johnMamish/Metronomev1/pcb/BOM.xlsx

Part Function |  | Value | Maufacturer | Manufacturer Part Number | Supplier | Supplier Part Number | Qty | Notes | TODOs
Major componenets
Main MCU | U1 |  | Atmel |  | Digikey |  | 1
System interconnect CPLD |  |  | Lattice Semiconductor | LCMXO2-640HC-4TG100C | Digikey | 220-1492-ND | 1
Audio DAC |  |  | Texas Instruments | PCM1774 | Digikey | 296-22036-1-ND | 1
UART <--> USB bridge |  |  | Silabs | CP2102-GMR | Digikey | 336-1160-1-ND | 1
3.3V LDO |  |  | ON Semiconductor |  | Digikey | MC33269D-3.3GOS-ND | 1
5V LDO |  |  | ON Semiconductor |  | Digikey | MC33269D-5.0GOS-ND | 1
Passives
3.3V regulator output smoothing cap | C16 |  | Kemet | T491A106K016AT | Digikey | 399-8269-1-ND | 1
5.0V regulator output smoothing cap | C15 |  | Kemet | T491A106K016AT | Digikey | 399-8269-1-ND | 1
Wall wart input smoothing cap | C1 |  | TDK Corporation | C1005JB1V334K050BC | Digikey | 445-11020-1-ND | 1
Main crystal oscillator | Y1 | 12MHz | TXC | 9C-12.000MEEJ-T | Digikey | 887-1268-1-ND | 1 |  | source SMALLER SMD!
Main crystal external capacitors | C2, C3 | 10pF | Kemet | CBR04C100F5GAC | Digikey | 399-8805-1-ND | 2 | According to the SAM4S datasheet, page 1146, Cext = 2*(Ccrystal - CL - Cpcb). From the datasheet, CL = 9.5pF. I can estimate the Cpcb = 3.5pF, so Cext = 2*(18 - 9.5 - 3.5) = 2*5 = 10pF
RTC Crystal
vddin smoothing cap 1 | C5 | 100nF | Kemet | C0402C104K4RACTU | Digikey | 399-3521-1-ND | 1
vddin smoothing cap 2 | C4 | 4.7uF | Kemet | C0603C475K8PACTU | Digikey | 399-5503-1-ND | 1
vddout smoothing cap 1 | C6 | 100nF | Kemet | C0402C104K4RACTU | Digikey | 399-3521-1-ND | 1
vddout smoothing cap 2 | C7 | 2.2uF | Kemet | C0603C225K8PACTU | Digikey | 399-4911-1-ND | 1
vddcore smoothing caps | C8, C11, C12 | 100nF | Kemet | C0402C104K4RACTU | Digikey | 399-3521-1-ND | 3
vddio smoothing caps | C9, C10, C13 | 100nF | Kemet | C0402C104K4RACTU | Digikey | 399-3521-1-ND | 3
CP2102 regulator smoothing caps | C17, C18 | 2.2uF, 100nF | Kemet | C0603C225K8PACTU, C0402C104K4RACTU | Digikey | 399-4911-1-ND, 399-3521-1-ND | 1, 1
CP2102 connection indication LED | D1 | Green | ??? | ??? | Sparkfun | COM-11169 | 1
CP2102 indication LED resistor | R3 | 100Ohm | Panasonic | ERJ-2GEJ101X | Digikey | P100JCT-ND | 1
CP2102 NC pullup resistor | R1 | 1kOhm | Panasonic | ERJ-2GEJ102X | Digikey | P1.0KJCT-ND | 1
CP2102 reset pullup resistor | R2 | 1kOhm | Panasonic | ERJ-2GEJ102X | Digikey | P1.0KJCT-ND | 1
Connectors
SWD Connector | J1 |  | FCI | 20021521-00010T1LF | Digikey | 609-4054-ND | 1
Power Barrel Plug | J2 |  | CUI Inc | PJ-202A | Sparkfun | PRT-00119 | 1
USB Mini B port | J3 |  | Hirose | UX60SC-MB-5ST(80) | Digikey | H11671CT-ND | 1
Development Tools
IDC (SWD) Cable |  |  | ??? | ??? | Adafruit | 1675
JTAG to SWD adapter board |  |  | Adafruit | 2094 | Adafruit | 2094
SAM-ICE |  |  | Segger | ??? | Digikey/"borrowing" from Ed | AT91SAM-ICE-ND
Bus blaster V3 for lattice machxo2 |  |  | Seeed Studio | TES04082P | Seeed Studio | TES04082P
