johnMamish/Metronomev1/pcb/metronome.brd

## EAGLE design pcb/metronome.brd (2014-12-04)

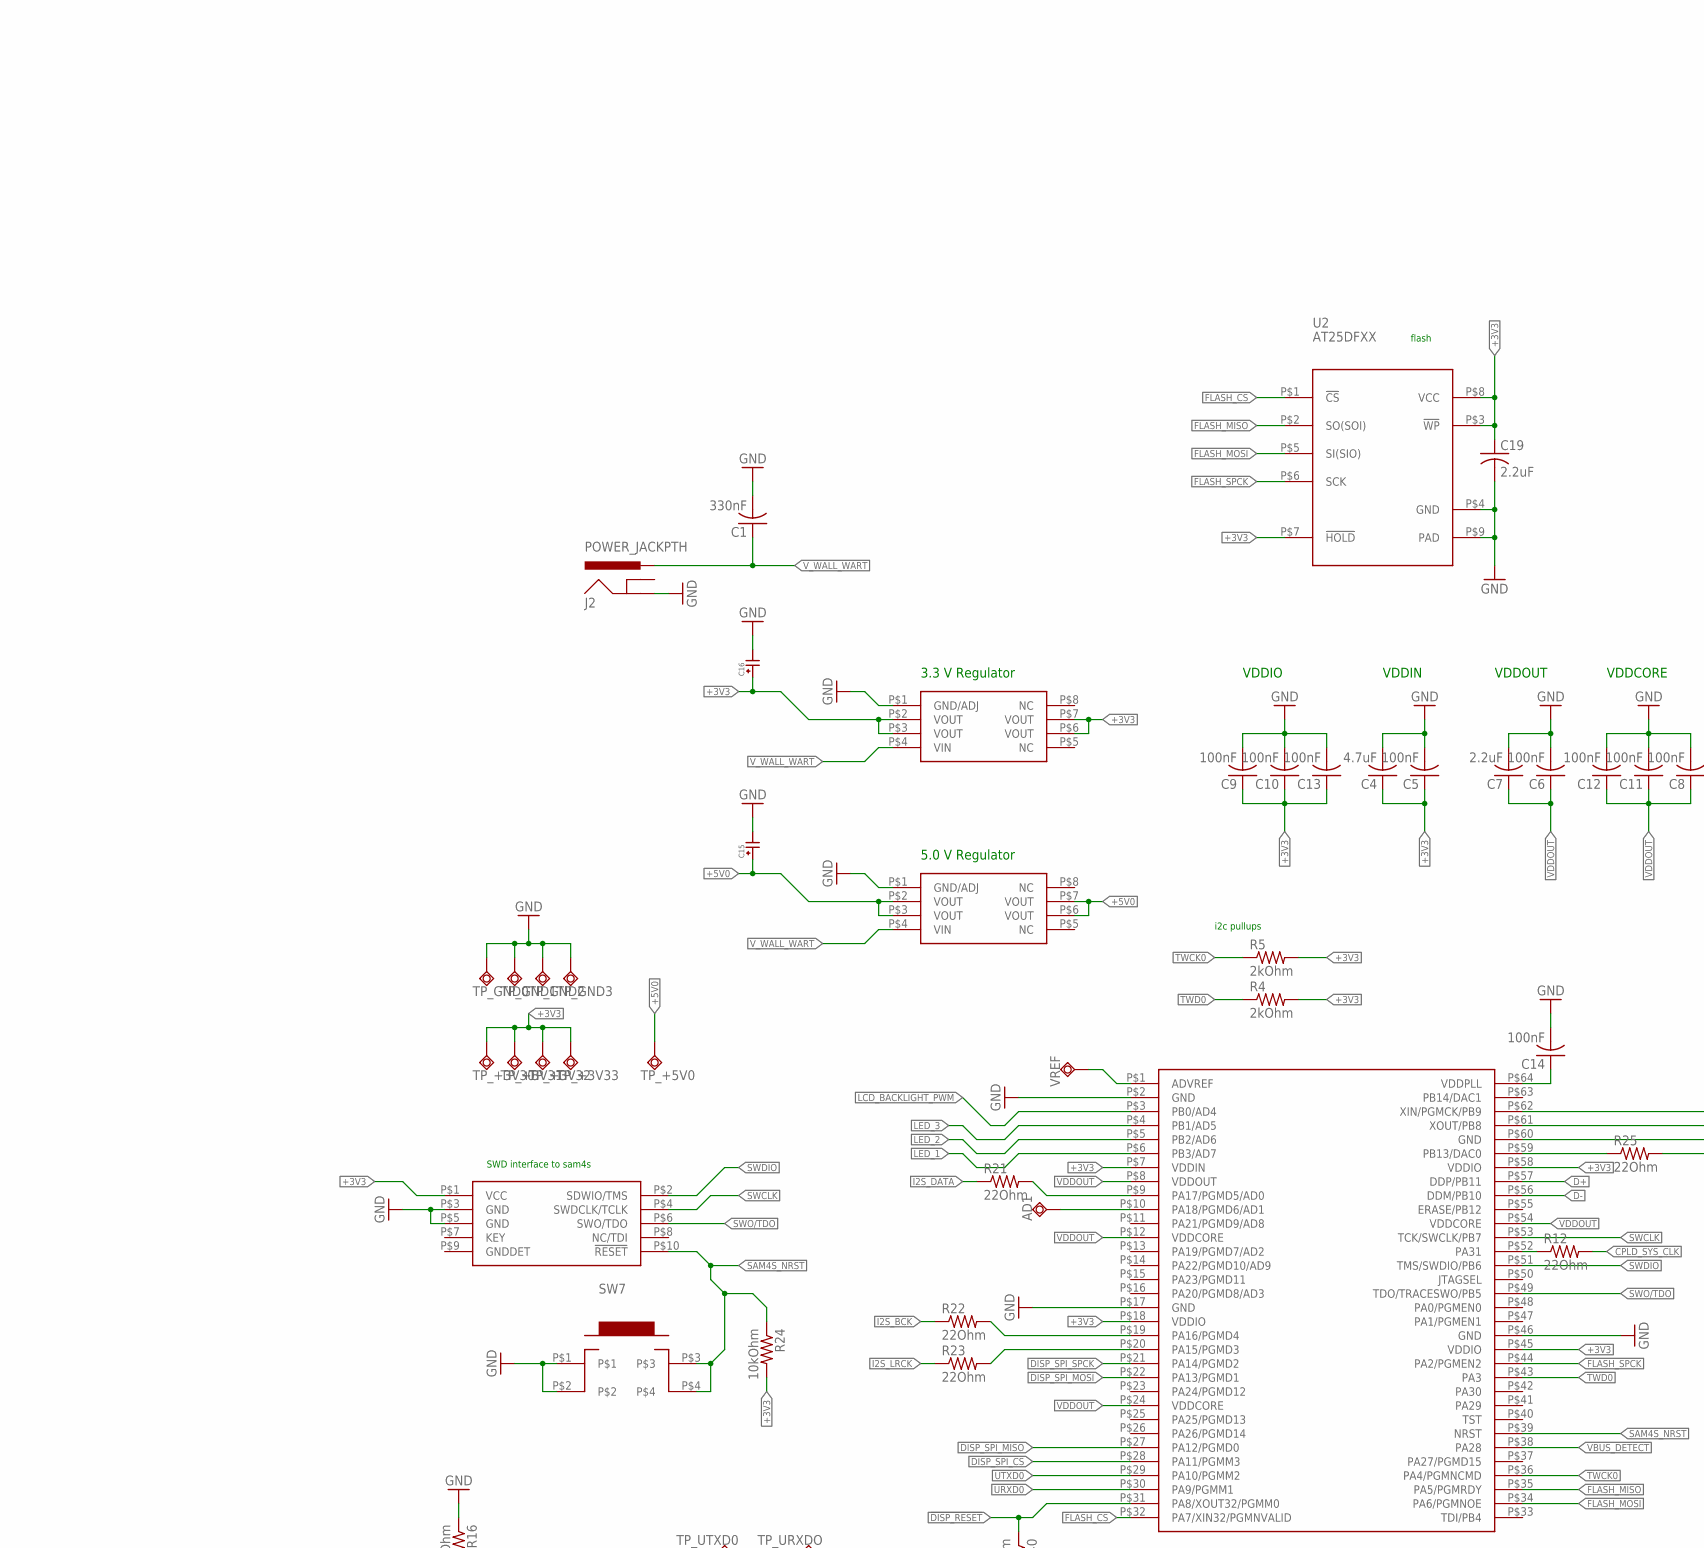
[picture p1: schematic metronome.sch, part in row 1, column 1]

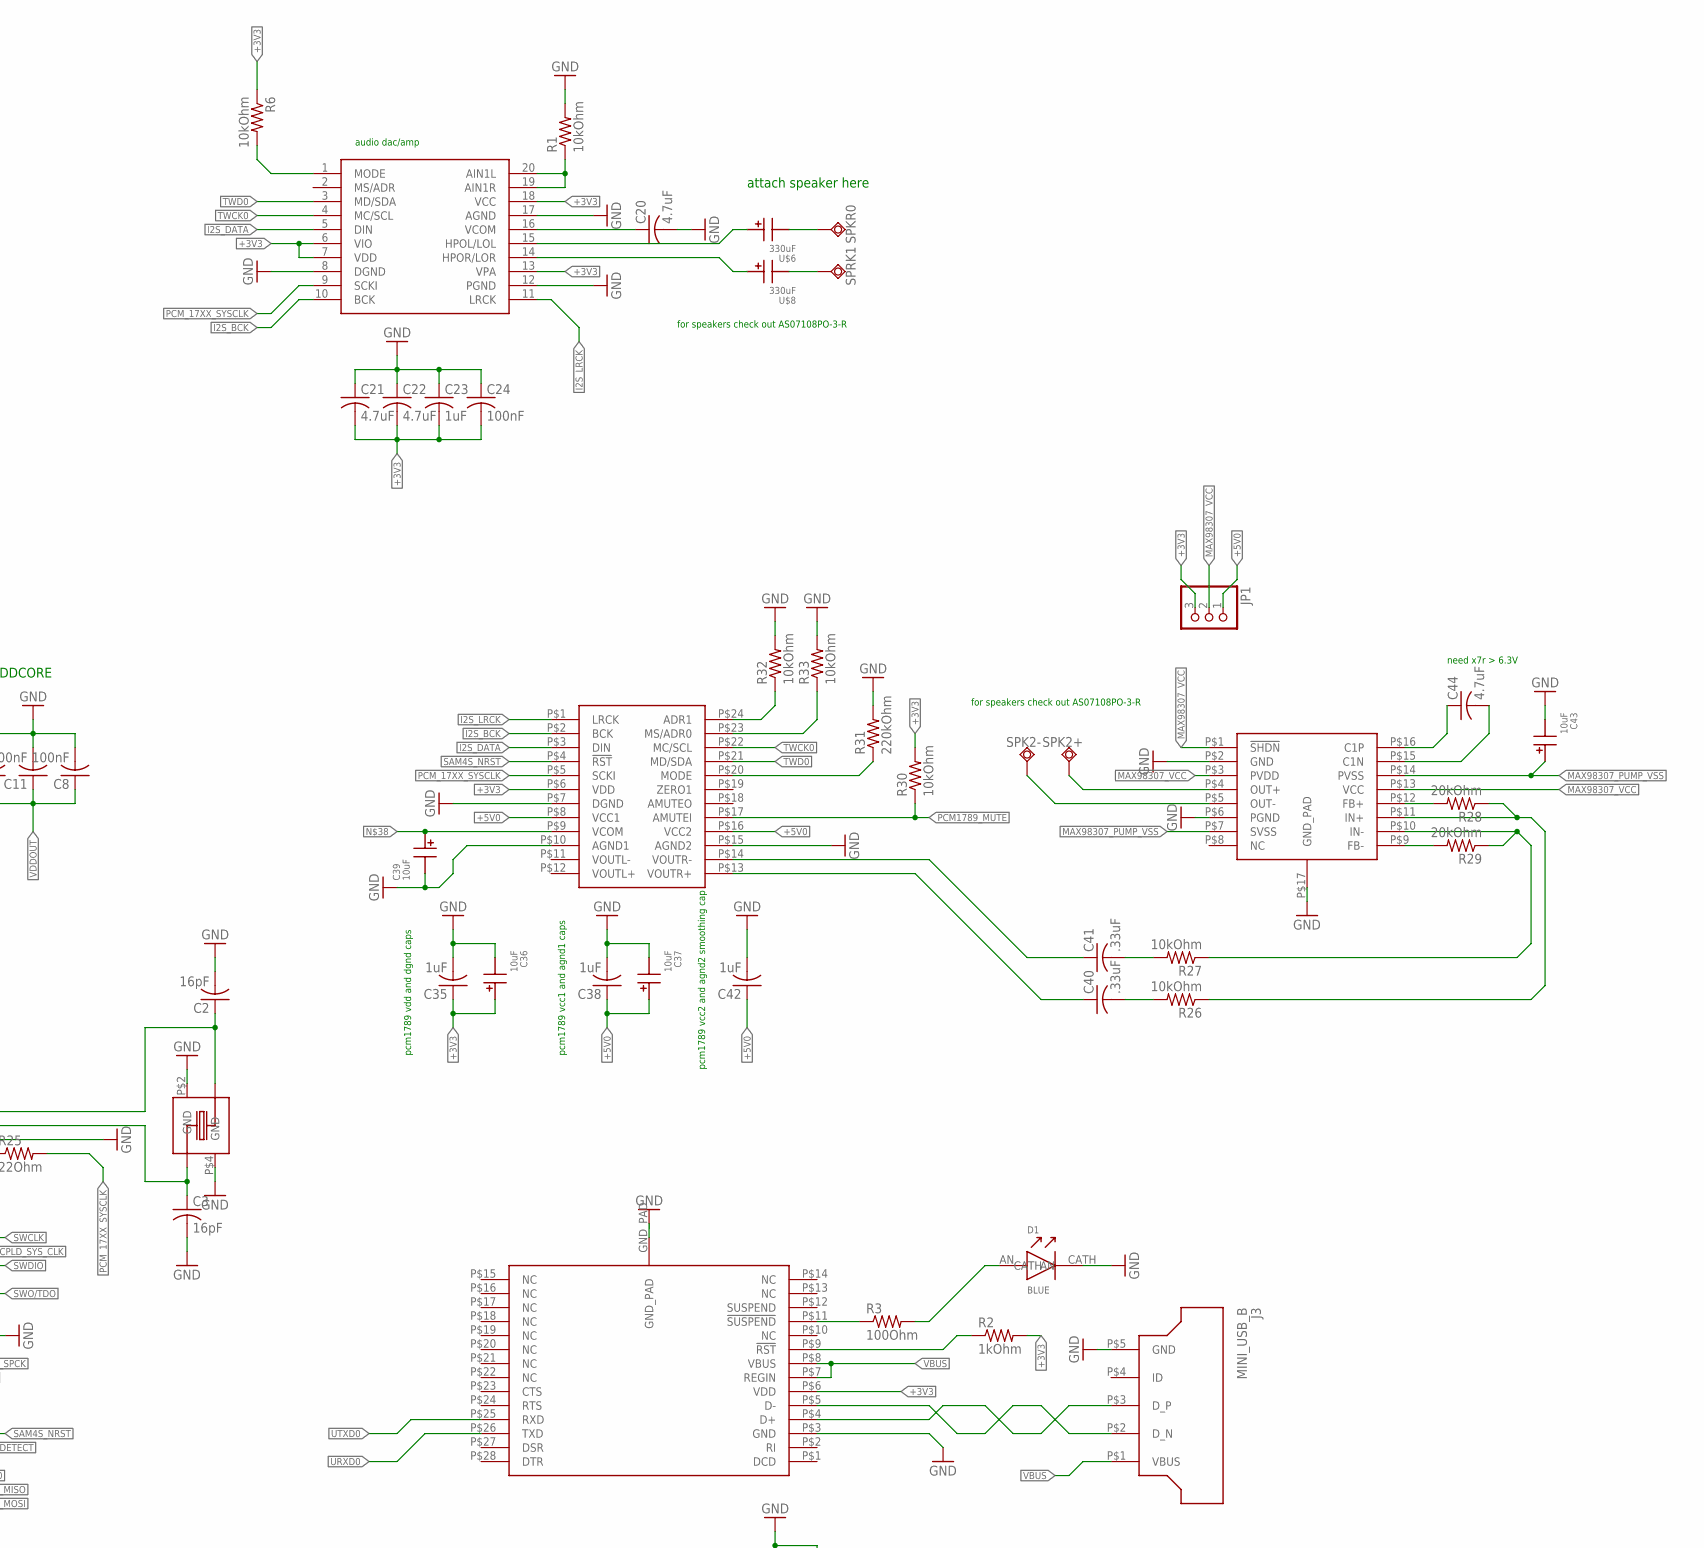
[picture p2: schematic metronome.sch, part in row 1, column 2]

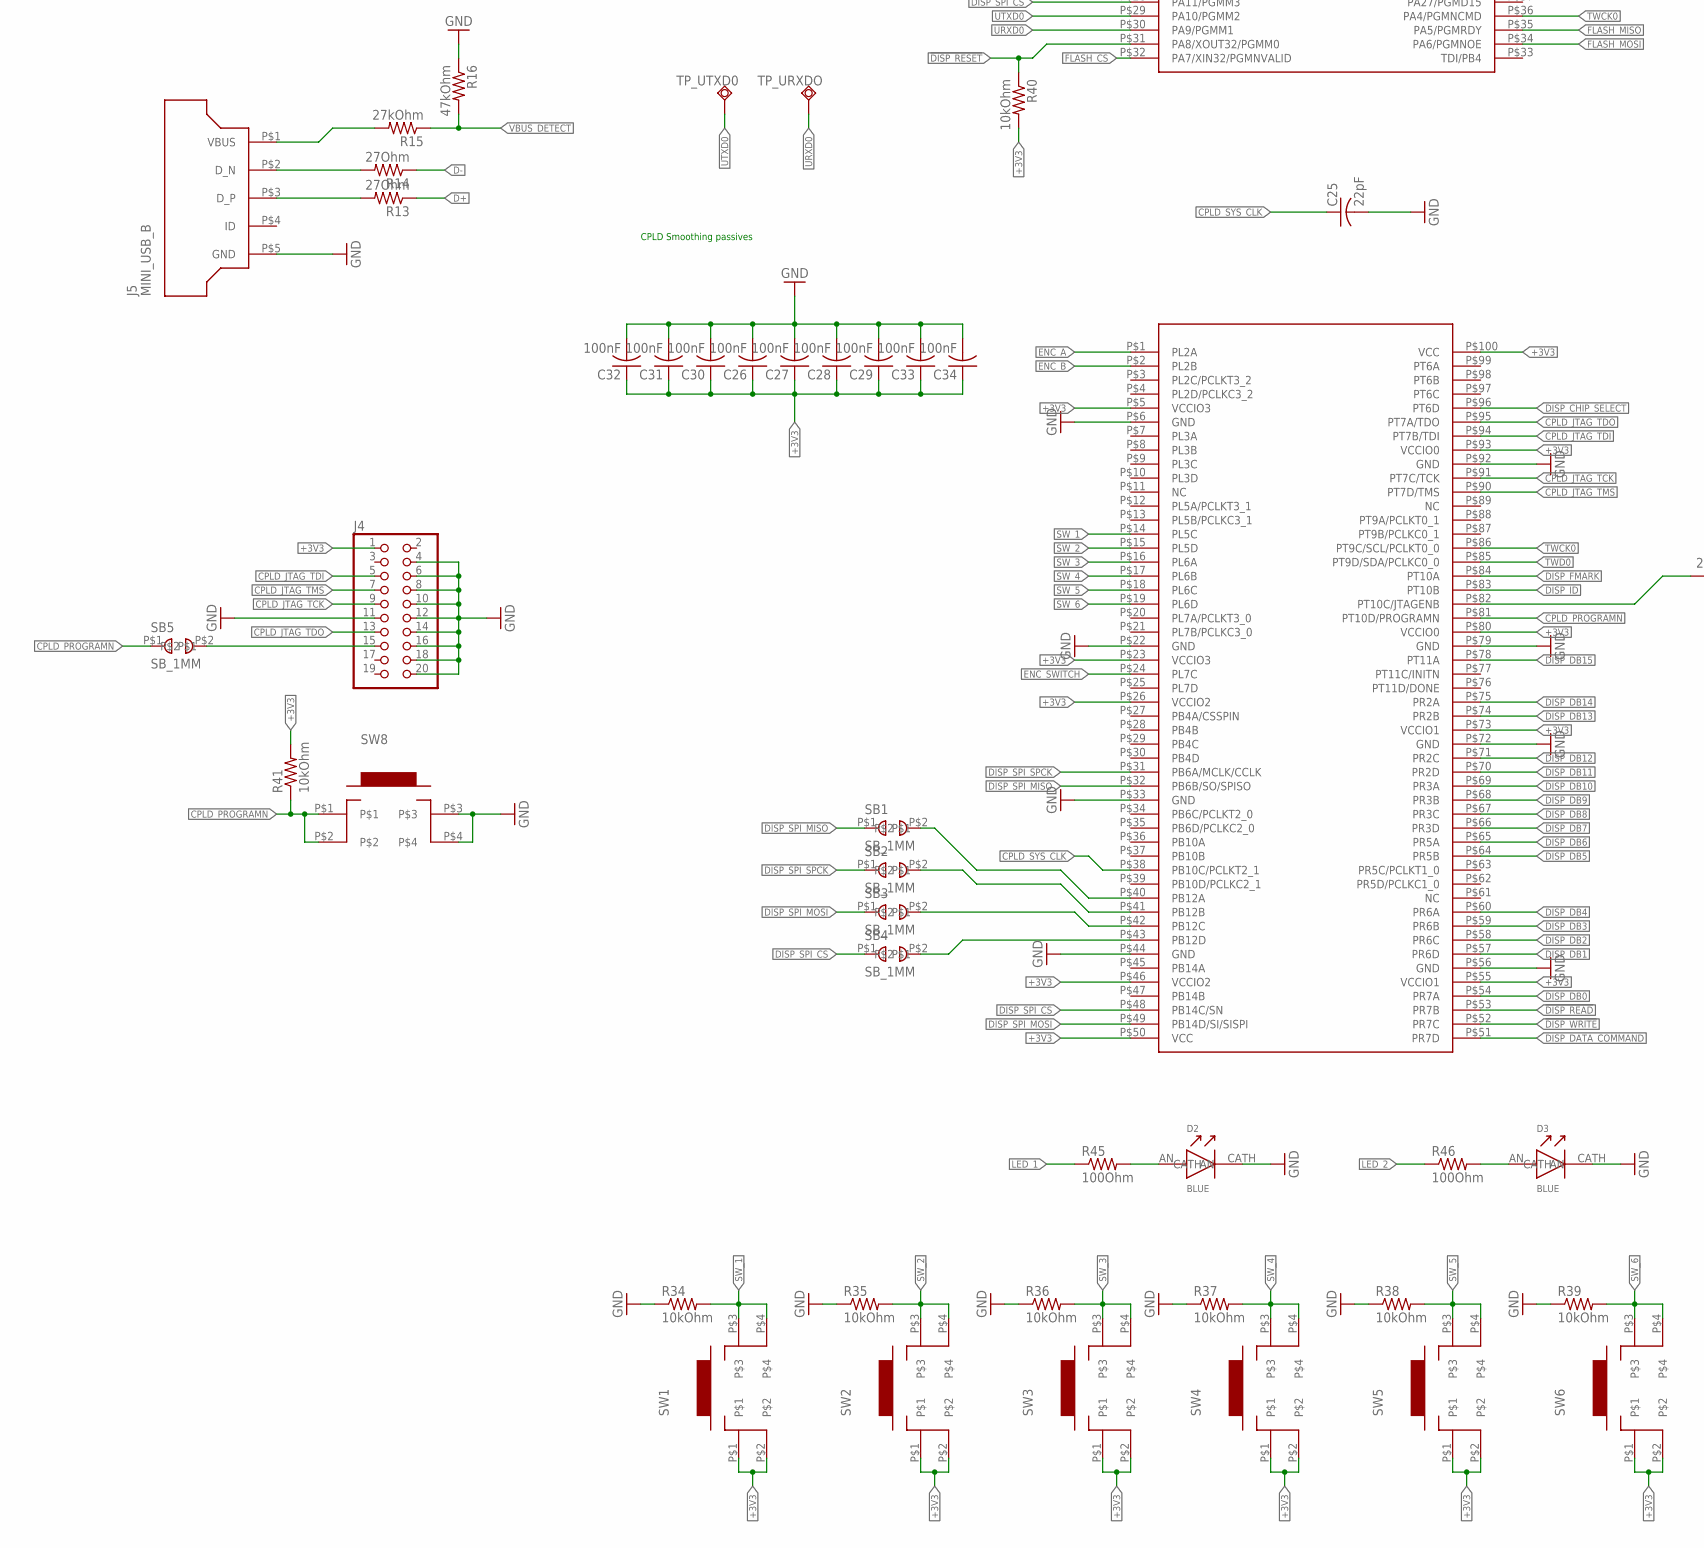
[picture p3: schematic metronome.sch, part in row 2, column 1]

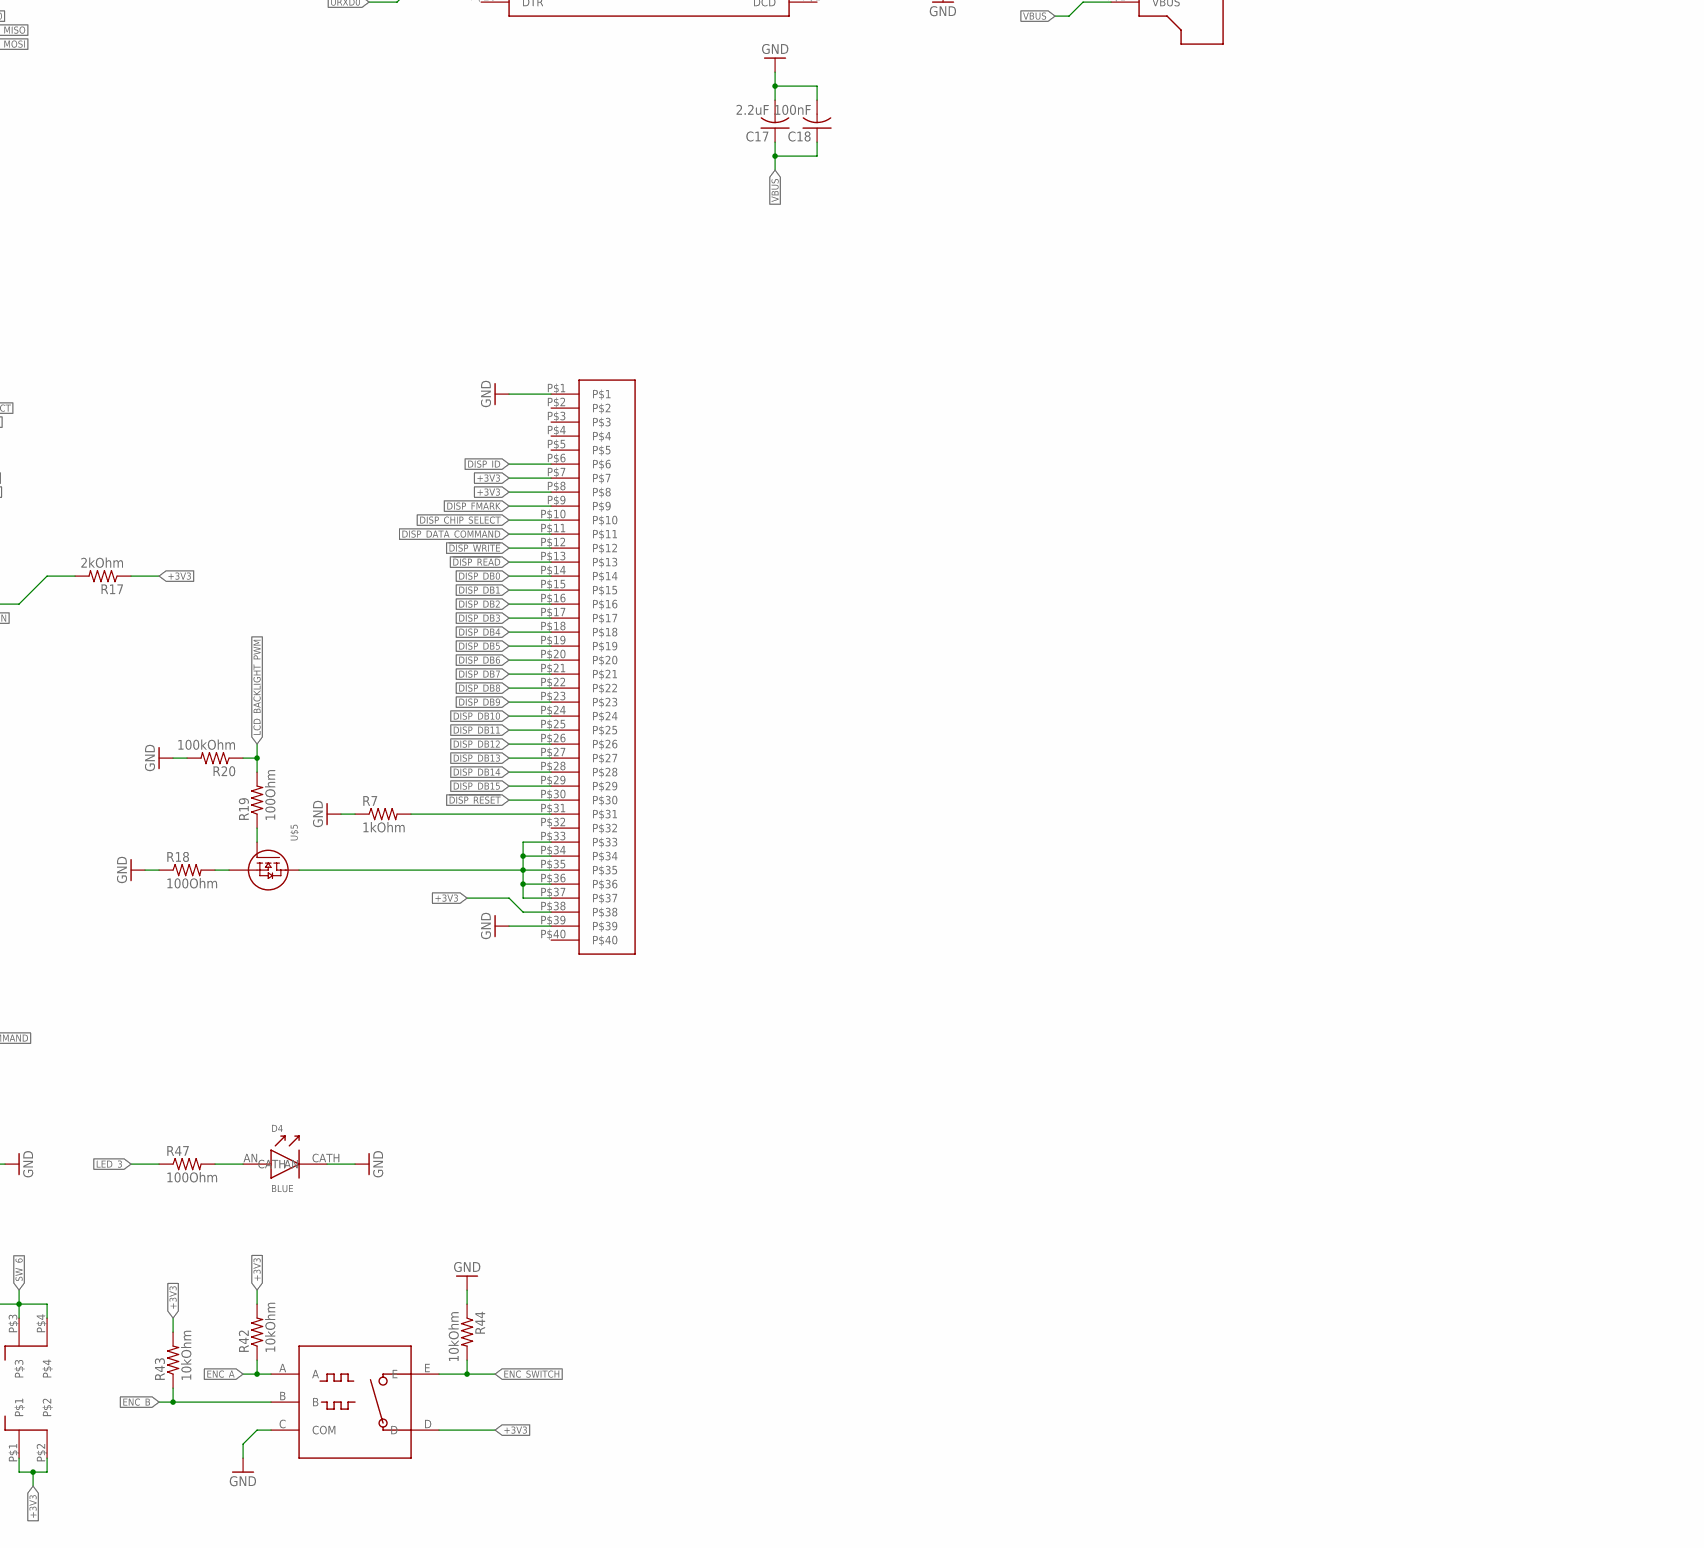
[picture p4: schematic metronome.sch, part in row 2, column 2]

Parts:
3.3_V_REG: MC33269D-3.3GOS-ND; ON_SEMICONDUCTOR_MC33269
5.0_V_REG: MC33269D-5.0GOS-ND; ON_SEMICONDUCTOR_MC33269
AD1: TPSQTP13SQ; TP13SQ
C1: 330nF; C0402
C2, C3: 16pF; C0402
C4, C44: 4.7uF; C0603
C5, C6, C8, C9, C10, C11, C12, C13, C14, C18, C24, C26, C27, C28, C29, C30, C31, C32, C33, C34: 100nF; C0402
C7, C17, C19: 2.2uF; C0603
C15, C16: KEMET_T491A
C20, C21, C22: 4.7uF; C0402
C23, C35, C38, C42: 1uF; C0402
C25: 22pF; C0402
C36, C37, C39, C43: 10uF; PANASONIC_EEEHB100AR
C40, C41: .33uF; C0402
D1, D2, D3, D4: BLUE; D0603
J1: FCI_CORTEX_SWD_CONNECTOR; FCI_10_PIN_SMD_0.5
J2: POWER_JACKPTH; POWER_JACK_PTH
J3, J5: MINI_USB_B; UX60SC-MB-5ST
J4: PINHD-2X10; 2X10
JP1: PINHD-1X3; 1X03
R1, R6, R24, R26, R27, R30, R32, R33, R34, R35, R36, R37, R38, R39, R40, R41, R42, R43, R44: 10kOhm; R0402
R2, R7: 1kOhm; R0402
R3, R18, R19, R45, R46, R47: 100Ohm; R0402
R4, R5, R17: 2kOhm; R0402
R12, R21, R22, R23, R25: 22Ohm; R0402
R13, R14: 27Ohm; R0402
R15: 27kOhm; R0402
R16: 47kOhm; R0402
R20: 100kOhm; R0402
R28, R29: 20kOhm; R0402
R31: 220kOhm; R0402
SB1, SB2, SB3, SB4, SB5: SB_1MM
SPK2+, SPK2-: TPSQTP20SQ; TP20SQ
SPKR0: TPSQTP20SQ; TP20SQ
SPRK1: TPSQTP20SQ; TP20SQ
SW1, SW2, SW3, SW4, SW5, SW6, SW7, SW8: FSMJSMA
TP_+3V30, TP_+3V31, TP_+3V32, TP_+3V33, TP_+5V0: TPSQTP20SQ; TP20SQ
TP_GND0, TP_GND1, TP_GND2, TP_GND3: TPSQTP20SQ; TP20SQ
TP_URXDO: TPSQTP20SQ; TP20SQ
TP_UTXD0: TPSQTP20SQ; TP20SQ
U1: ATSAMD4S2BA-AU; ATMEL_10X10_QFP_64
U2: AT25DFXX1X-M; 8MA1-UDFN
U$1: LATTICE_LCMXO2-640HC-4TG100C; LATTICE_MACHXO_TQFP100
U$2: TI_PCM1774; TI_QFN_20
U$3: ECS_ECS-120-20-33-CKM-TR; ECS_ECX-32
U$4: 40_PIN_MOLEX_FFC
U$5: DIODES_INCORPORATED_2N7002-7-F; DIODES_INCORPORATED_SOT23
U$6, U$8: 330uF; PANASONIC_EEEFT0JXXX
U$7: SILABS_CP2102; SILABS_QFN28
U$9: TI_PCM1789; TI_PW_TSSOP_24
U$10: MAXIM_MAX_98307; MAXIM_16_TQFN_T1633-5
U$11: BOURNS_PEC16-4215F-S0024; BOURNS_PEC16-4XXXF-SXXXX
VREF: TPSQTP13SQ; TP13SQ

Connections:
!DISP_READ!: U$1.P$53 (PR7B), U$4.P$13
!DISP_RESET!: R40.1, U1.P$31 (PA8/XOUT32/PGMM0), U$4.P$30
!DISP_WRITE!: U$1.P$52 (PR7C), U$4.P$12
+3V3: 3.3_V_REG.P$2 (VOUT), 3.3_V_REG.P$3 (VOUT), 3.3_V_REG.P$6 (VOUT), 3.3_V_REG.P$7 (VOUT), C4.1, C5.1, C9.1, C10.1, C13.1, C16.POS, C19.1, C21.2, C22.2, C23.2, C24.2, C26.1, C27.1, C28.1, C29.1, C30.1, C31.1, C32.1, C33.1, C34.1, C35.1, C36.POS, J1.P$1 (VCC), J4.1, JP1.3, R2.2, R4.2, R5.2, R6.1, R17.1, R24.2, R30.2, R40.2, R41.2, R42.2, R43.2, SW1.P$1, SW1.P$2, SW2.P$1, SW2.P$2, SW3.P$1, SW3.P$2, SW4.P$1, SW4.P$2, SW5.P$1, SW5.P$2, SW6.P$1, SW6.P$2, TP_+3V30.TP, TP_+3V31.TP, TP_+3V32.TP, TP_+3V33.TP, U1.P$7 (VDDIN), U1.P$18 (VDDIO), U1.P$45 (VDDIO), U1.P$58 (VDDIO), U2.P$3 (!WP!), U2.P$7 (!HOLD!), U2.P$8 (VCC), U$1.P$5 (VCCIO3), U$1.P$23 (VCCIO3), U$1.P$26 (VCCIO2), U$1.P$46 (VCCIO2), U$1.P$50 (VCC), U$1.P$55 (VCCIO1), U$1.P$73 (VCCIO1), U$1.P$80 (VCCIO0), U$1.P$93 (VCCIO0), U$1.P$100 (VCC), U$2.6 (VIO), U$2.7 (VDD), U$2.13 (VPA), U$2.18 (VCC), U$4.P$7, U$4.P$8, U$4.P$38, U$7.P$6 (VDD), U$9.P$6 (VDD), U$11.D
+5V0: 5.0_V_REG.P$2 (VOUT), 5.0_V_REG.P$3 (VOUT), 5.0_V_REG.P$6 (VOUT), 5.0_V_REG.P$7 (VOUT), C15.POS, C37.POS, C38.1, C42.1, JP1.1, TP_+5V0.TP, U$9.P$8 (VCC1), U$9.P$16 (VCC2)
CPLD_JTAG_TCK: J4.9, U$1.P$91 (PT7C/TCK)
CPLD_JTAG_TDI: J4.5, U$1.P$94 (PT7B/TDI)
CPLD_JTAG_TDO: J4.13, U$1.P$95 (PT7A/TDO)
CPLD_JTAG_TMS: J4.7, U$1.P$90 (PT7D/TMS)
CPLD_PROGRAMN: R41.1, SB5.P$1, SW8.P$1, SW8.P$2, U$1.P$81 (PT10D/PROGRAMN)
CPLD_SYS_CLK: C25.1, R12.2, U$1.P$38 (PB10C/PCLKT2_1)
D+: R13.1, U1.P$57 (DDP/PB11)
D-: R14.1, U1.P$56 (DDM/PB10)
DISP_CHIP_SELECT: U$1.P$96 (PT6D), U$4.P$10
DISP_DATA_COMMAND: U$1.P$51 (PR7D), U$4.P$11
DISP_DB0: U$1.P$54 (PR7A), U$4.P$14
DISP_DB1: U$1.P$57 (PR6D), U$4.P$15
DISP_DB2: U$1.P$58 (PR6C), U$4.P$16
DISP_DB3: U$1.P$59 (PR6B), U$4.P$17
DISP_DB4: U$1.P$60 (PR6A), U$4.P$18
DISP_DB5: U$1.P$64 (PR5B), U$4.P$19
DISP_DB6: U$1.P$65 (PR5A), U$4.P$20
DISP_DB7: U$1.P$66 (PR3D), U$4.P$21
DISP_DB8: U$1.P$67 (PR3C), U$4.P$22
DISP_DB9: U$1.P$68 (PR3B), U$4.P$23
DISP_DB10: U$1.P$69 (PR3A), U$4.P$24
DISP_DB11: U$1.P$70 (PR2D), U$4.P$25
DISP_DB12: U$1.P$71 (PR2C), U$4.P$26
DISP_DB13: U$1.P$74 (PR2B), U$4.P$27
DISP_DB14: U$1.P$75 (PR2A), U$4.P$28
DISP_DB15: U$1.P$78 (PT11A), U$4.P$29
DISP_FMARK: U$1.P$84 (PT10A), U$4.P$9
DISP_ID: U$1.P$83 (PT10B), U$4.P$6
DISP_SPI_CS: SB4.P$1, U1.P$28 (PA11/PGMM3), U$1.P$48 (PB14C/SN)
DISP_SPI_MISO: SB1.P$1, U1.P$27 (PA12/PGMD0), U$1.P$32 (PB6B/SO/SPISO)
DISP_SPI_MOSI: SB3.P$1, U1.P$22 (PA13/PGMD1), U$1.P$49 (PB14D/SI/SISPI)
DISP_SPI_SPCK: SB2.P$1, U1.P$21 (PA14/PGMD2), U$1.P$31 (PB6A/MCLK/CCLK)
ENC_A: R42.1, U$1.P$1 (PL2A), U$11.A
ENC_B: R43.1, U$1.P$2 (PL2B), U$11.B
ENC_SWITCH: R44.2, U$1.P$24 (PL7C), U$11.E
FLASH_CS: U1.P$32 (PA7/XIN32/PGMNVALID), U2.P$1 (!CS!)
FLASH_MISO: U1.P$35 (PA5/PGMRDY), U2.P$2 (SO(SOI))
FLASH_MOSI: U1.P$34 (PA6/PGMNOE), U2.P$5 (SI(SIO))
FLASH_SPCK: U1.P$44 (PA2/PGMEN2), U2.P$6 (SCK)
GND: 3.3_V_REG.P$1 (GND/ADJ), 5.0_V_REG.P$1 (GND/ADJ), C1.2, C2.2, C3.2, C4.2, C5.2, C6.2, C7.2, C8.2, C9.2, C10.2, C11.2, C12.2, C13.2, C14.2, C15.NEG, C16.NEG, C17.2, C18.2, C19.2, C20.2, C21.1, C22.1, C23.1, C24.1, C25.2, C26.2, C27.2, C28.2, C29.2, C30.2, C31.2, C32.2, C33.2, C34.2, C35.2, C36.NEG, C37.NEG, C38.2, C39.NEG, C42.2, C43.NEG, D1.CATH, D2.CATH, D3.CATH, D4.CATH, J1.P$3 (GND), J1.P$5 (GND), J2.GND, J3.P$5 (GND), J4.4, J4.6, J4.8, J4.10, J4.11, J4.12, J4.14, J4.16, J4.18, J4.20, J5.P$5 (GND), R1.2, R7.1, R16.1, R18.1, R20.2, R31.2, R32.2, R33.2, R34.1, R35.1, R36.1, R37.1, R38.1, R39.1, R44.1, SW7.P$1, SW7.P$2, SW8.P$3, SW8.P$4, TP_GND0.TP, TP_GND1.TP, TP_GND2.TP, TP_GND3.TP, U1.P$2 (GND), U1.P$17 (GND), U1.P$46 (GND), U1.P$60 (GND), U2.P$4 (GND), U2.P$9 (PAD), U$1.P$6 (GND), U$1.P$22 (GND), U$1.P$33 (GND), U$1.P$44 (GND), U$1.P$56 (GND), U$1.P$72 (GND), U$1.P$79 (GND), U$1.P$92 (GND), U$2.8 (DGND), U$2.12 (PGND), U$2.17 (AGND), U$3.P$2 (GND), U$3.P$4 (GND), U$4.P$1, U$4.P$39, U$7.GND_PAD, U$7.P$3 (GND), U$9.P$7 (DGND), U$9.P$10 (AGND1), U$9.P$15 (AGND2), U$10.P$2 (GND), U$10.P$6 (PGND), U$10.P$17 (GND_PAD), U$11.C (COM)
I2S_BCK: R22.1, U$2.10 (BCK), U$9.P$2 (BCK)
I2S_DATA: R21.1, U$2.5 (DIN), U$9.P$3 (DIN)
I2S_DATA_MCU: R21.2, U1.P$9 (PA17/PGMD5/AD0)
I2S_LRCK: R23.1, U$2.11 (LRCK), U$9.P$1 (LRCK)
I2S_LR_SELECT_MCU: R23.2, U1.P$20 (PA15/PGMD3)
LCD_BACKLIGHT_PWM: R19.2, R20.1, U1.P$3 (PB0/AD4)
LED_1: R45.1, U1.P$6 (PB3/AD7)
LED_2: R46.1, U1.P$5 (PB2/AD6)
LED_3: R47.1, U1.P$4 (PB1/AD5)
MAX98307_PUMP_VSS: C43.POS, U$10.P$7 (SVSS), U$10.P$14 (PVSS)
MAX98307_VCC: JP1.2, U$10.P$1 (!SHDN!), U$10.P$3 (PVDD), U$10.P$13 (VCC)
unnamed: R2.1, U$7.P$9 (!RST!)
unnamed: SB2.P$2, U$1.P$41 (PB12B)
unnamed: SPKR0.TP, U$6.NEG
unnamed: R3.1, U$7.P$11 (!SUSPEND!)
unnamed: D1.AN, R3.2
unnamed: C14.1, U1.P$64 (VDDPLL)
unnamed: U1.P$1 (ADVREF), VREF.TP
unnamed: AD1.TP, U1.P$10 (PA18/PGMD6/AD1)
unnamed: R12.1, U1.P$52 (PA31)
unnamed: SB4.P$2, U$1.P$43 (PB12D)
unnamed: SB3.P$2, U$1.P$42 (PB12C)
unnamed: J5.P$3 (D_P), R13.2
unnamed: R7.2, U$4.P$31
unnamed: J5.P$2 (D_N), R14.2
unnamed: R17.2, U$1.P$82 (PT10C/JTAGENB)
unnamed: U$4.P$33, U$4.P$34, U$4.P$35, U$4.P$36, U$4.P$37, U$5.P$3 (DRAIN)
unnamed: J5.P$1 (VBUS), R15.2
unnamed: R1.1, U$2.19 (AIN1R), U$2.20 (AIN1L)
unnamed: R6.2, U$2.1 (MODE)
unnamed: R18.2, U$5.P$2 (SOURCE)
unnamed: C20.1, U$2.16 (VCOM)
unnamed: R19.1, U$5.P$1 (GATE)
unnamed: SB1.P$2, U$1.P$40 (PB12A)
unnamed: U$2.15 (HPOL/LOL), U$6.POS
unnamed: U$2.14 (HPOR/LOR), U$8.POS
unnamed: SPRK1.TP, U$8.NEG
unnamed: R22.2, U1.P$19 (PA16/PGMD4)
unnamed: R25.1, U1.P$59 (PB13/DAC0)
unnamed: C41.1, U$9.P$14 (VOUTR-)
unnamed: C40.1, U$9.P$13 (VOUTR+)
unnamed: C41.2, R27.2
unnamed: C40.2, R26.2
unnamed: R26.1, R28.1, U$10.P$11 (IN+)
unnamed: R27.1, R29.1, U$10.P$10 (IN-)
unnamed: R28.2, U$10.P$12 (FB+)
unnamed: C39.POS, U$9.P$9 (VCOM)
unnamed: R29.2, U$10.P$9 (FB-)
unnamed: R31.1, U$9.P$20 (MODE)
unnamed: R32.1, U$9.P$24 (ADR1)
unnamed: D2.AN, R45.2
unnamed: D3.AN, R46.2
unnamed: SPK2+.TP, U$10.P$4 (OUT+)
unnamed: SPK2-.TP, U$10.P$5 (OUT-)
unnamed: D4.AN, R47.2
unnamed: J4.15, SB5.P$2
unnamed: R33.1, U$9.P$23 (MS/ADR0)
unnamed: C44.2, U$10.P$15 (C1N)
unnamed: C44.1, U$10.P$16 (C1P)
PCM1789_MUTE: R30.1, U$9.P$17 (AMUTEI)
PCM_17XX_SYSCLK: R25.2, U$2.9 (SCKI), U$9.P$5 (SCKI)
SAM4S_NRST: J1.P$10 (!RESET!), R24.1, SW7.P$3, SW7.P$4, U1.P$39 (NRST), U$9.P$4 (!RST!)
SERIAL_USB+: J3.P$3 (D_P), U$7.P$4 (D+)
SERIAL_USB-: J3.P$2 (D_N), U$7.P$5 (D-)
SWCLK: J1.P$4 (SWDCLK/TCLK), U1.P$53 (TCK/SWCLK/PB7)
SWDIO: J1.P$2 (SDWIO/TMS), U1.P$51 (TMS/SWDIO/PB6)
SWO/TDO: J1.P$6 (SWO/TDO), U1.P$49 (TDO/TRACESWO/PB5)
SW_1: R34.2, SW1.P$3, SW1.P$4, U$1.P$14 (PL5C)
SW_2: R35.2, SW2.P$3, SW2.P$4, U$1.P$15 (PL5D)
SW_3: R36.2, SW3.P$3, SW3.P$4, U$1.P$16 (PL6A)
SW_4: R37.2, SW4.P$3, SW4.P$4, U$1.P$17 (PL6B)
SW_5: R38.2, SW5.P$3, SW5.P$4, U$1.P$18 (PL6C)
SW_6: R39.2, SW6.P$3, SW6.P$4, U$1.P$19 (PL6D)
TWCK0: R5.1, U1.P$36 (PA4/PGMNCMD), U$1.P$86 (PT9C/SCL/PCLKT0_0), U$2.4 (MC/SCL), U$9.P$22 (MC/SCL)
TWD0: R4.1, U1.P$43 (PA3), U$1.P$85 (PT9D/SDA/PCLKC0_0), U$2.3 (MD/SDA), U$9.P$21 (MD/SDA)
URXD0: TP_URXDO.TP, U1.P$30 (PA9/PGMM1), U$7.P$26 (TXD)
UTXD0: TP_UTXD0.TP, U1.P$29 (PA10/PGMM2), U$7.P$25 (RXD)
VBUS: C17.1, C18.1, J3.P$1 (VBUS), U$7.P$7 (REGIN), U$7.P$8 (VBUS)
VBUS_DETECT: R15.1, R16.2, U1.P$38 (PA28)
VDDOUT: C6.1, C7.1, C8.1, C11.1, C12.1, U1.P$8 (VDDOUT), U1.P$12 (VDDCORE), U1.P$24 (VDDCORE), U1.P$54 (VDDCORE)
V_WALL_WART: 3.3_V_REG.P$4 (VIN), 5.0_V_REG.P$4 (VIN), C1.1, J2.PWR
XIN: C2.1, U1.P$62 (XIN/PGMCK/PB9), U$3.P$1
XOUT: C3.1, U1.P$61 (XOUT/PB8), U$3.P$3

Notes on the sheet:
5.0 V Regulator
3.3 V Regulator
VDDIN
VDDOUT
VDDIO
VDDCORE
i2c pullups
CPLD Smoothing passives
SWD interface to sam4s
audio dac/amp
flash
attach speaker here
pcm1789 vdd and dgnd caps
pcm1789 vcc1 and agnd1 caps
pcm1789 vcc2 and agnd2 smoothing cap
need x7r > 6.3V
for speakers check out AS07108PO-3-R

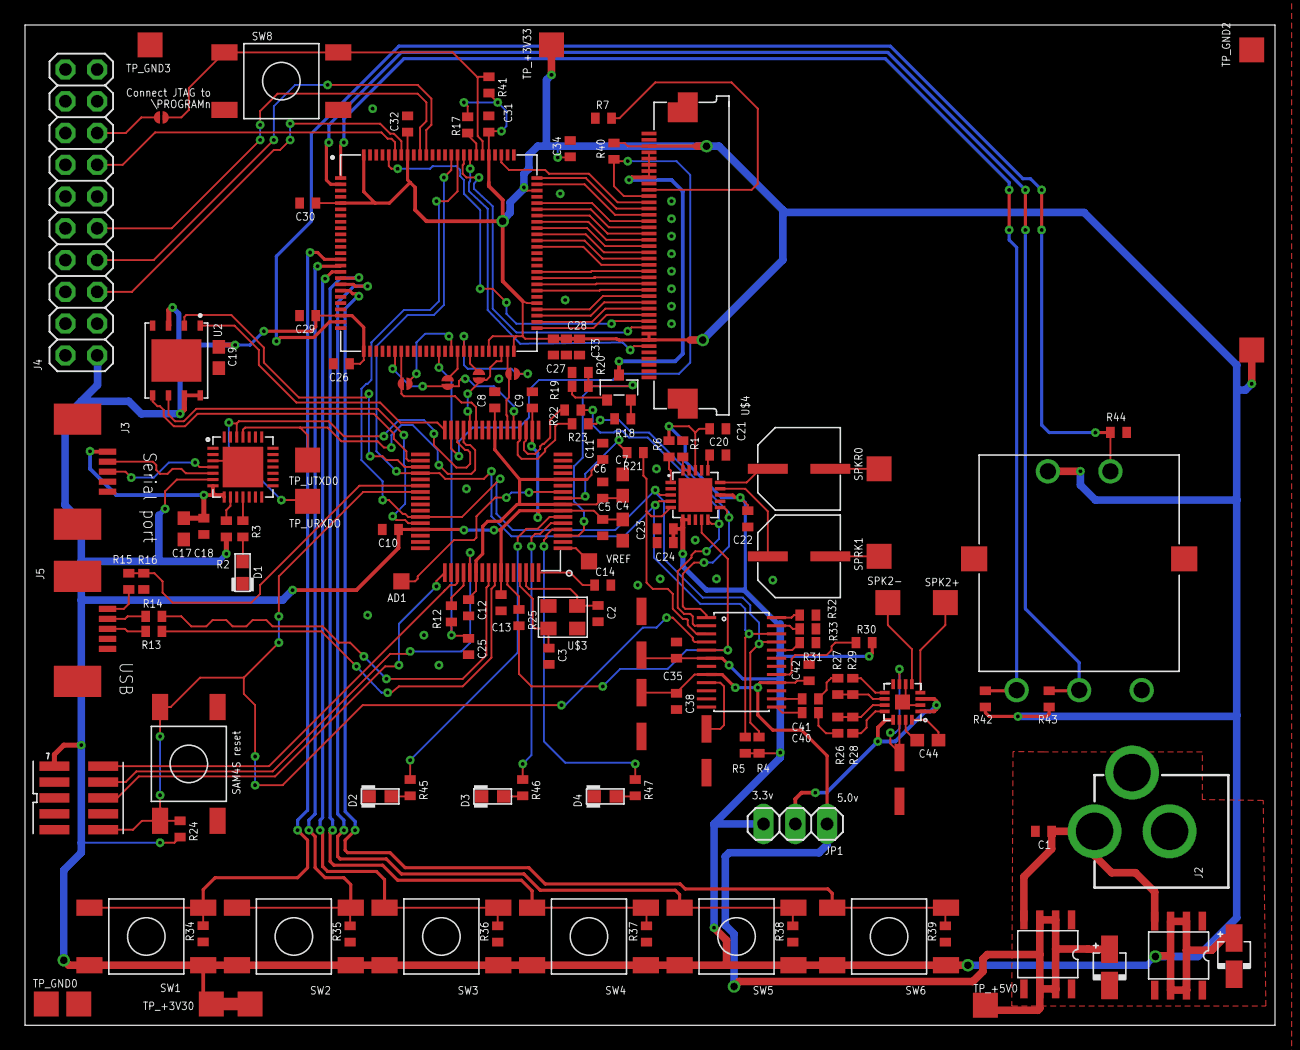
[picture p5: board metronome.brd from above]

Board: 2 copper layers, 100.0 x 80.0 mm, 142 parts (0 on the bottom side), 128 nets.
